brandonhuang68/SynestheticXylophone/README.md

# SynestheticXylophone
ME102B Spring 2019
Authored by: Brandon Huang, Jenny Wong, and Christina Ngo

This repository contains the necessary libraries and files to run our synesthetic xylophone.

1. SXLibrary - Arduino Libraries to synchronize and control all actuators.
2. ImageProcessing - scripts to process images into an Arduino readable format.
3. INOs - Arduino scripts for the microcontroller.

Please read the "Synesthetic Xylophone Report.pdf" for more details.
