brandonhuang68/SynestheticXylophone/INOs/README.md

#INOs
Arduino .ino files require that they be placed in a directory of the same name.
